Djensonsan/EE5/Arduino Ventilator/readme

All resources for the Arduino Uno that implements: Motor shield for the ventilator, temperature sensor and CAN bus communication.
