Djensonsan/EE5/Mower_1/PCB + SCH + BOM/mini-position-sensor.brd

## EAGLE design Mower_1/PCB + SCH + BOM/mini-position-sensor.brd (2019-05-21)

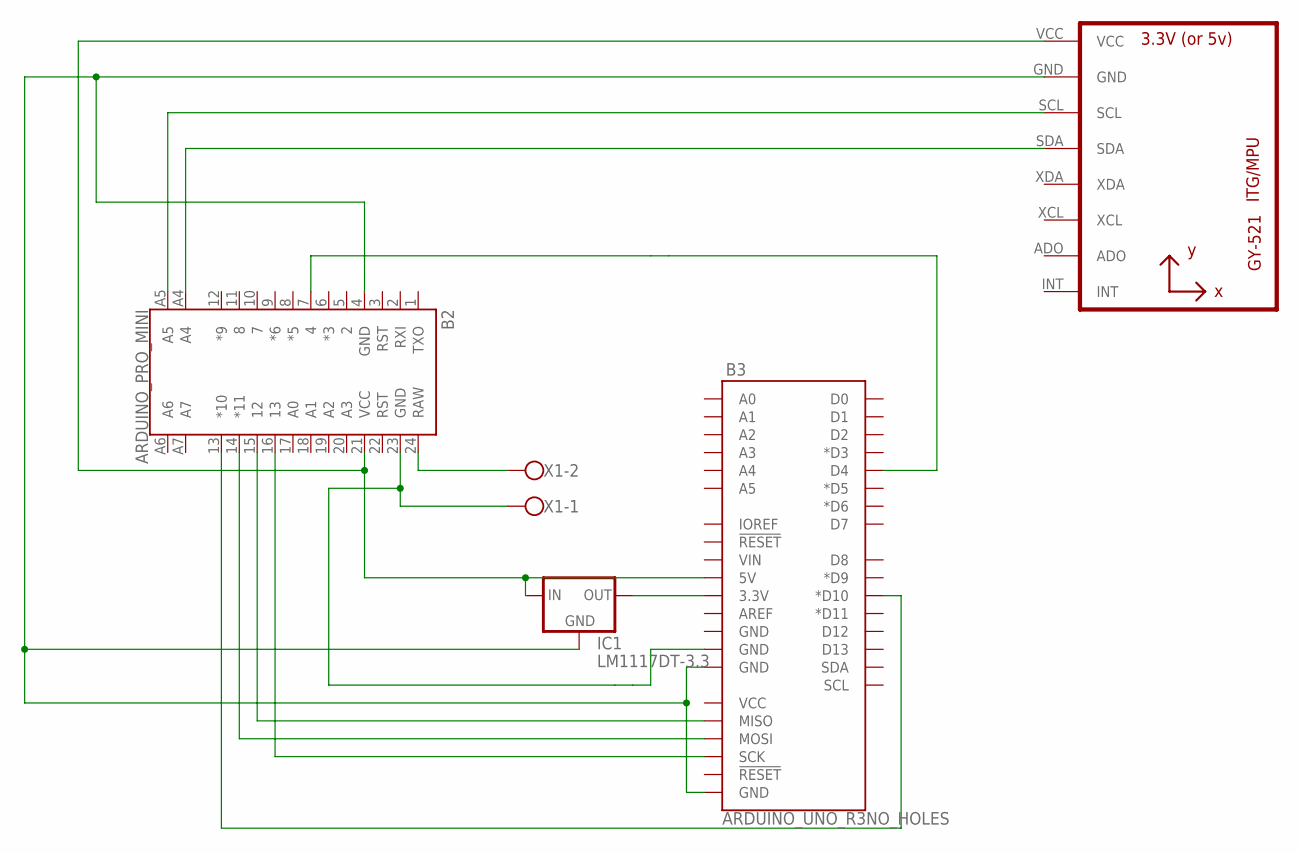
[picture p21: schematic mini-position-sensor.sch]

Parts:
B2: ARDUINO_PRO_MINI
B3: ARDUINO_UNO_R3NO_HOLES; ARDUINO_R3_NO_HOLES
IC1: LM1117DT-3.3; TO252
U1: GY-521MPU6050; GY-521
X1: W237-102

Connections:
unnamed: B2.7 (4), B3.D4
unnamed: B2.4 (GND), B3.GND@1 (GND), B3.GND@2 (GND), IC1.1 (GND), U1.GND
unnamed: B2.14 (*11), B3.MOSI
unnamed: B2.15 (12), B3.MISO
unnamed: B2.A4, U1.SDA
unnamed: B2.A5, U1.SCL
unnamed: B3.3.3V, IC1.3 (OUT)
unnamed: B2.24 (RAW), X1.2
unnamed: B2.16 (13), B3.SCK
unnamed: B2.13 (*10), B3.D10 (*D10)
unnamed: B2.23 (GND), B3.GND@3 (GND), X1.1
unnamed: B2.21 (VCC), B3.5V, IC1.2 (IN), U1.VCC

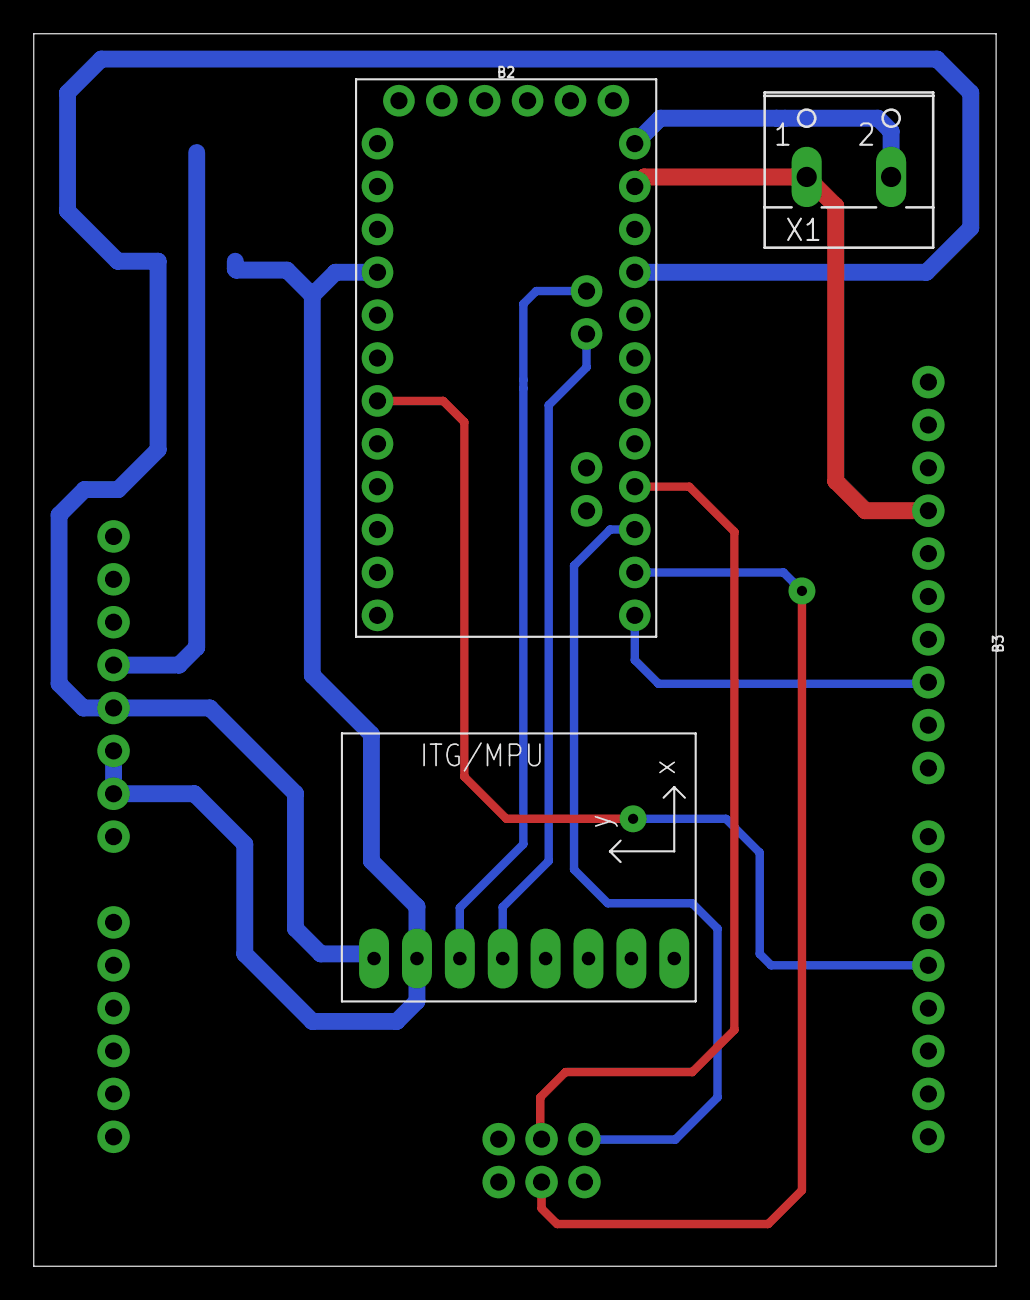
[picture p22: board mini-position-sensor.brd from above]

Board: 2 copper layers, 57.0 x 73.0 mm, 5 parts (1 on the bottom side), 12 nets.
