Djensonsan/EE5/Mower_1/PCB + SCH + BOM/amplifier.brd

## EAGLE design Mower_1/PCB + SCH + BOM/amplifier.brd (2019-05-21)

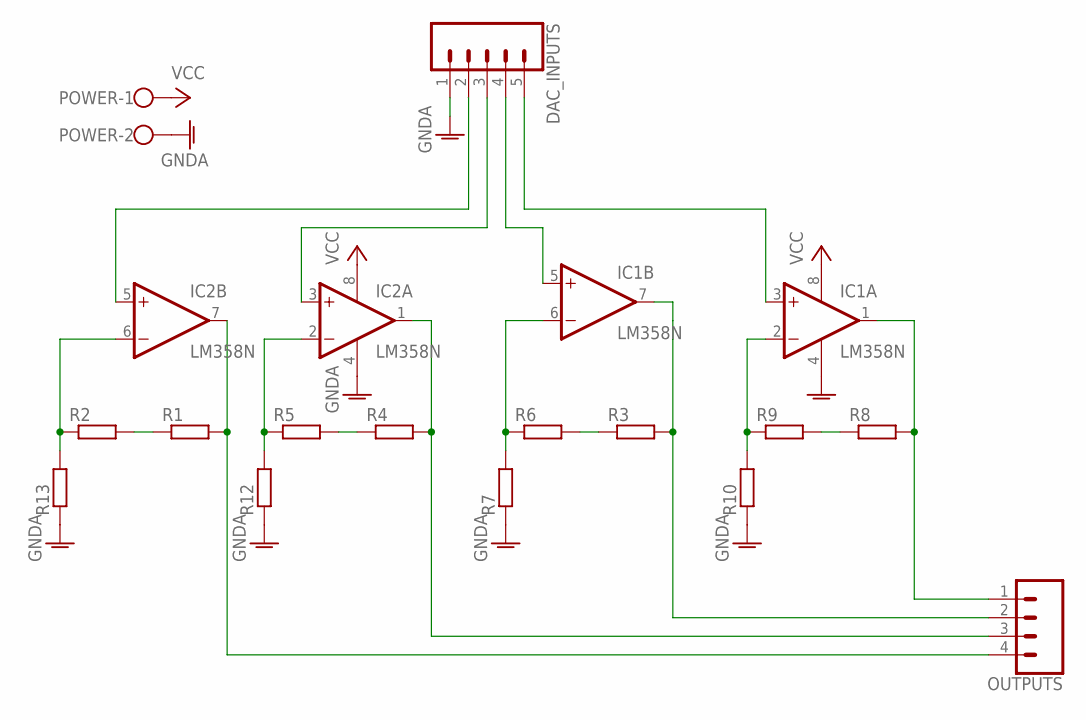
[picture p23: schematic amplifier.sch]

Parts:
DAC_INPUTS: CONN_05; 1X05
IC1, IC2: LM358N; DIL08
OUTPUTS: CONN_04; 1X04
POWER: W237-102
R1, R2, R3, R4, R5, R6, R7, R8, R9, R10, R12, R13: R-EU_0204/7; 0204/7

Connections:
GNDA: DAC_INPUTS.1, IC1.4 (V-), IC2.4 (V-), POWER.2, R7.1, R10.1, R12.1, R13.1
unnamed: DAC_INPUTS.5, IC1.3 (+IN)
unnamed: DAC_INPUTS.3, IC2.3 (+IN)
unnamed: DAC_INPUTS.4, IC1.5 (+IN)
unnamed: DAC_INPUTS.2, IC2.5 (+IN)
unnamed: IC2.1 (OUT), OUTPUTS.3, R4.2
unnamed: IC2.2 (-IN), R5.1, R12.2
unnamed: R4.1, R5.2
unnamed: IC2.7 (OUT), OUTPUTS.4, R1.2
unnamed: R1.1, R2.2
unnamed: IC2.6 (-IN), R2.1, R13.2
unnamed: R3.1, R6.2
unnamed: IC1.6 (-IN), R6.1, R7.2
unnamed: IC1.7 (OUT), OUTPUTS.2, R3.2
unnamed: R8.1, R9.2
unnamed: IC1.2 (-IN), R9.1, R10.2
unnamed: IC1.1 (OUT), OUTPUTS.1, R8.2
VCC: IC1.8 (V+), IC2.8 (V+), POWER.1

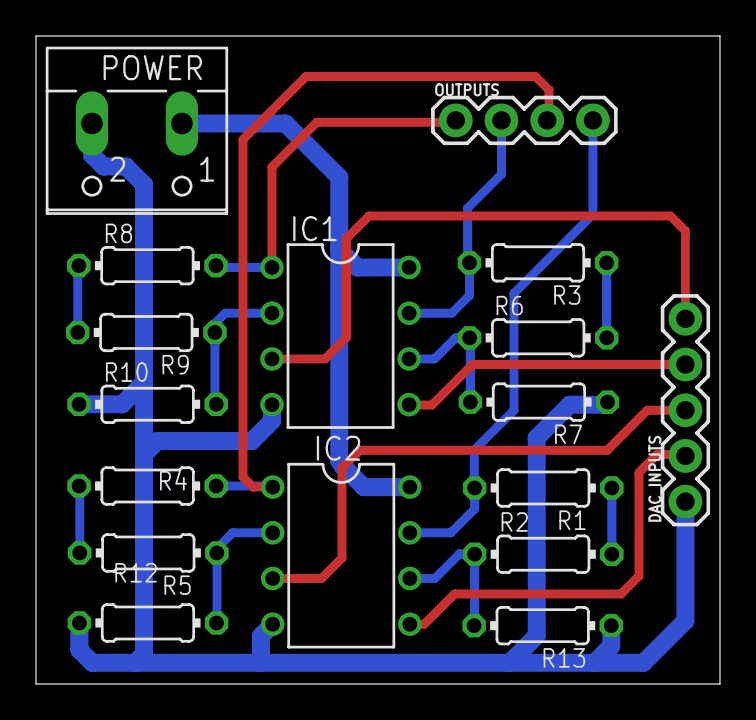
[picture p24: board amplifier.brd from above]

Board: 2 copper layers, 38.0 x 36.0 mm, 17 parts (0 on the bottom side), 18 nets.
