Djensonsan/EE5/Mower_1/PCB + SCH + BOM/mega-shield.brd

## EAGLE design Mower_1/PCB + SCH + BOM/mega-shield.brd (2019-05-21)

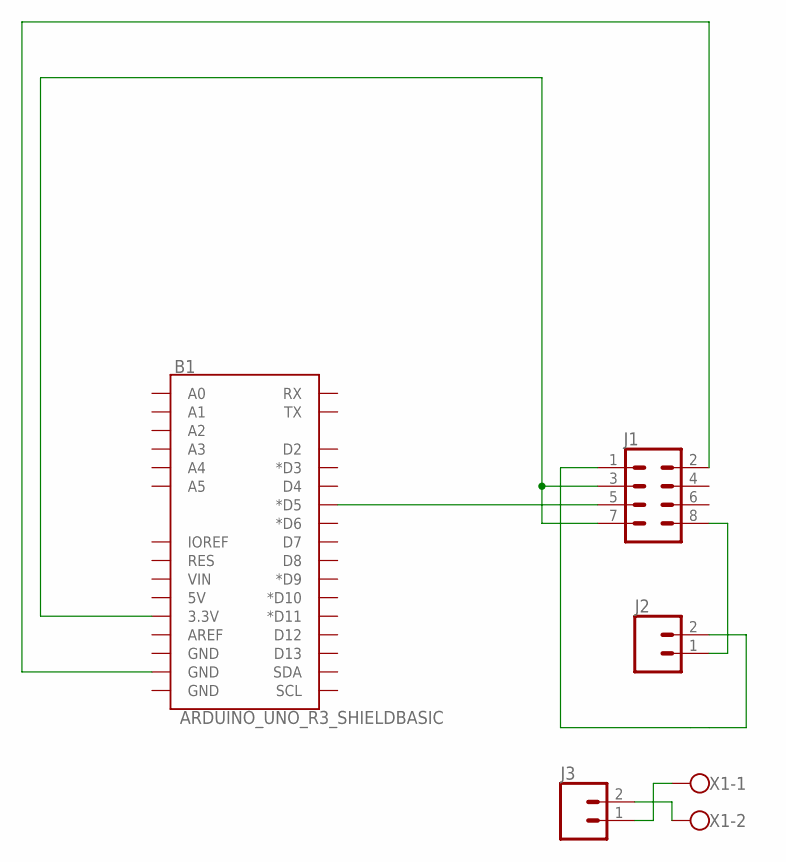
[picture p25: schematic mega-shield.sch]

Parts:
B1: ARDUINO_UNO_R3_SHIELDBASIC; UNO_R3_SHIELD
J1: CONN_04X2; 2X4
J2, J3: CONN_02; 1X02
X1: W237-102

Connections:
unnamed: B1.3.3V, J1.3, J1.7
unnamed: J1.8, J2.1
unnamed: B1.D5 (*D5), J1.5
unnamed: J1.1, J2.2
unnamed: J3.1, X1.1
unnamed: B1.GND@1 (GND), J1.2
unnamed: J3.2, X1.2

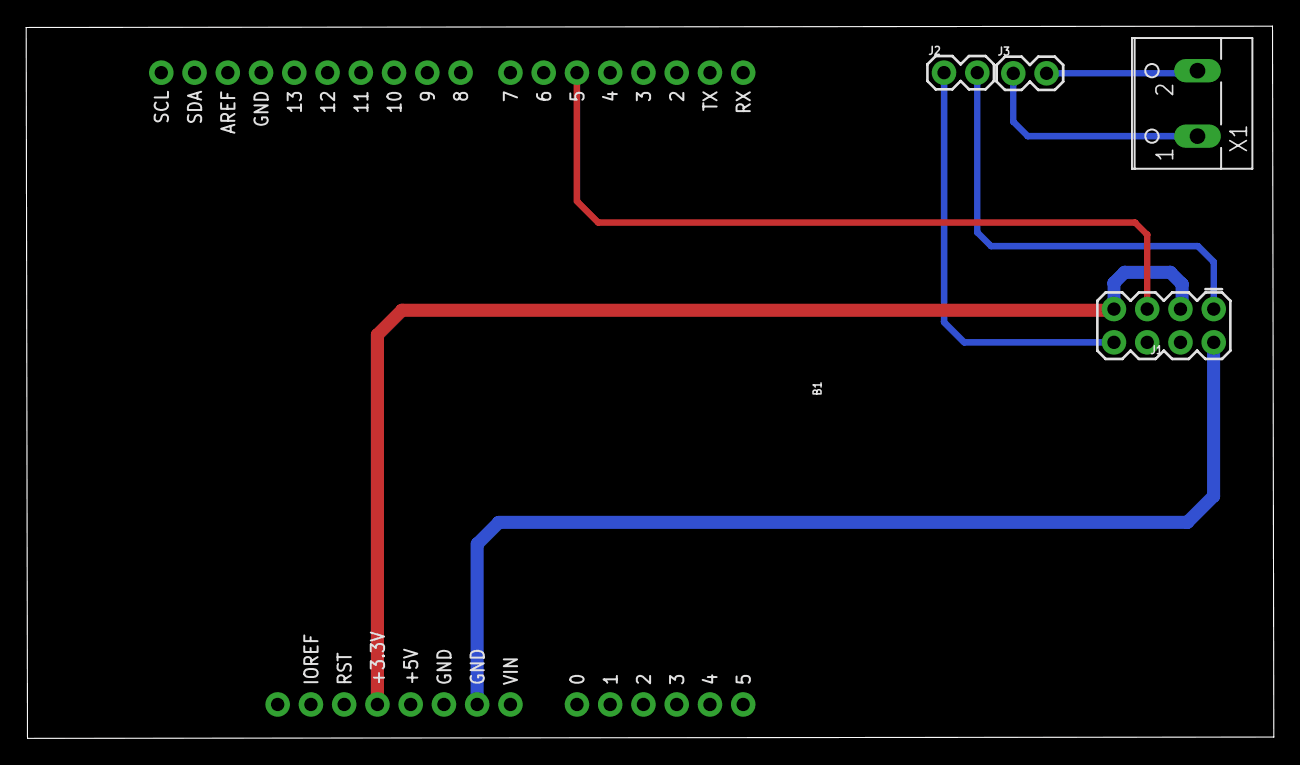
[picture p26: board mega-shield.brd from above]

Board: 2 copper layers, 95.3 x 54.4 mm, 5 parts (0 on the bottom side), 7 nets.
