Djensonsan/EE5/Mower_1/PCB + SCH + BOM/joystick-DAC-GPS.brd

## EAGLE design Mower_1/PCB + SCH + BOM/joystick-DAC-GPS.brd (2019-05-21)

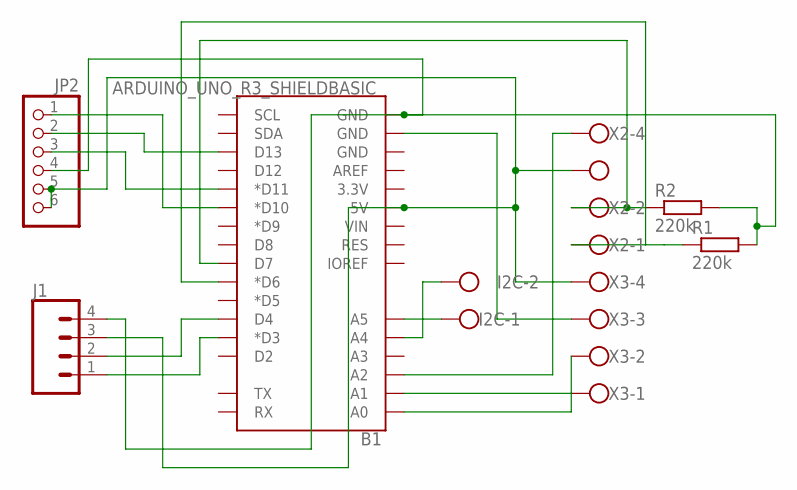
[picture p27: schematic joystick-DAC-GPS.sch]

Parts:
B1: ARDUINO_UNO_R3_SHIELDBASIC; UNO_R3_SHIELD
I2C: W237-102
J1: CONN_04; 1X04
JP2: PINHD-1X6; 1X06
R1, R2: 220k; 0204/7
X2, X3: W237-4

Connections:
unnamed: B1.5V, J1.3, JP2.5, JP2.6, X2.3, X3.4
unnamed: B1.A0, X3.2
unnamed: B1.A1, X3.1
unnamed: B1.GND@1 (GND), X3.3
unnamed: B1.GND@0 (GND), J1.4, JP2.4, R1.2, R2.2
unnamed: B1.A4, I2C.2
unnamed: B1.A5, I2C.1
unnamed: B1.A2, X2.4
unnamed: B1.D10 (*D10), JP2.1
unnamed: B1.D7, R2.1, X2.2
unnamed: B1.D11 (*D11), JP2.3
unnamed: B1.D13, JP2.2
unnamed: B1.D6 (*D6), R1.1, X2.1
unnamed: B1.D3 (*D3), J1.1
unnamed: B1.D4, J1.2

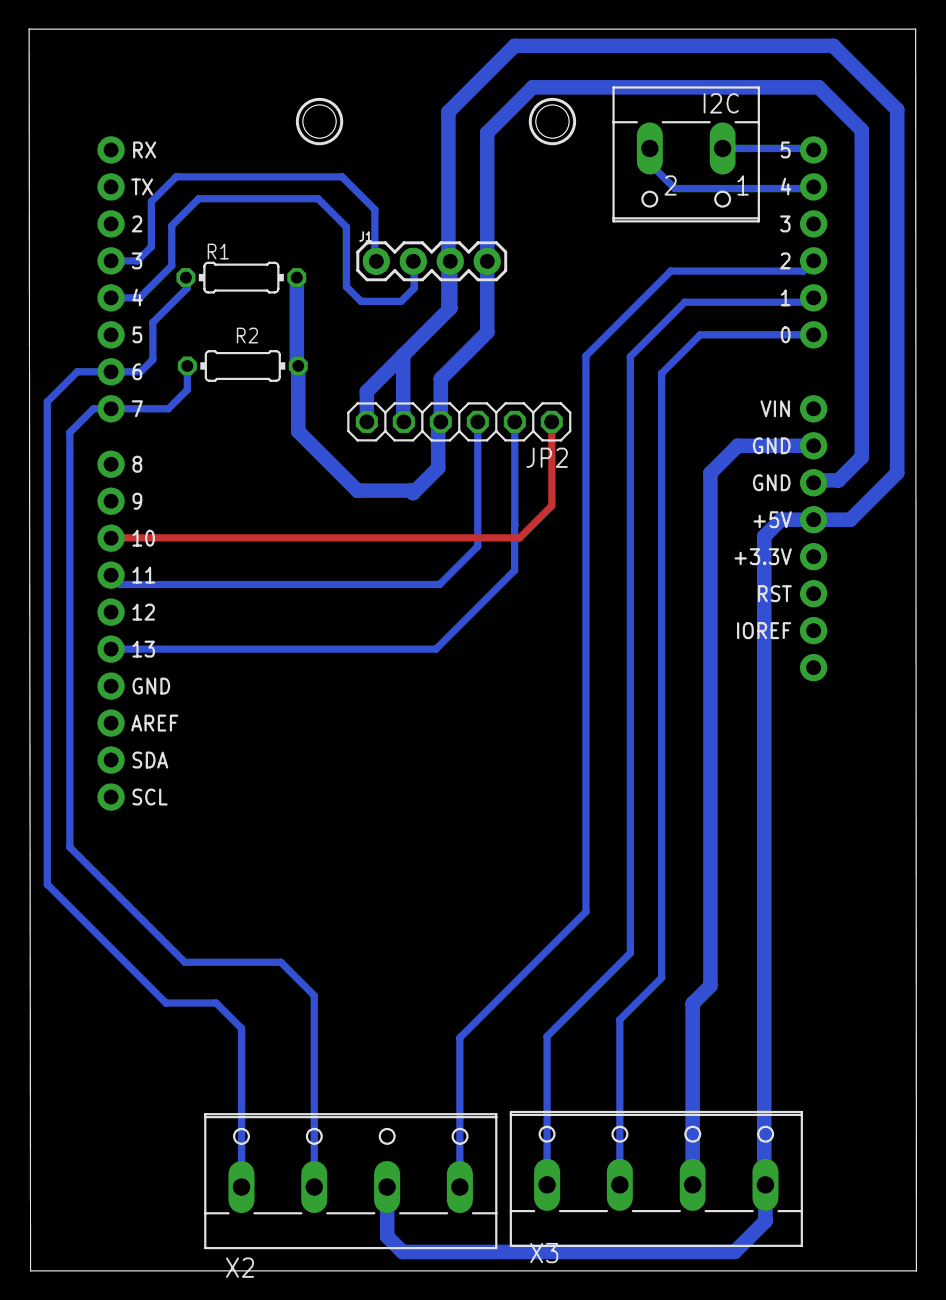
[picture p28: board joystick-DAC-GPS.brd from above]

Board: 2 copper layers, 61.0 x 85.3 mm, 8 parts (0 on the bottom side), 15 nets.
