Djensonsan/EE5/Mower_1/Arduino_Position_Sensors/Arduino_rotation.ino

//Code taken from MPU6050-DMP example code by Jeff Rowberg to which we added code to get a reference value for the gyroscope
#include "I2Cdev.h"
#include "MPU6050_6Axis_MotionApps20.h"
#include "Wire.h"
#include "df_can.h"

MPU6050 mpu;
MCPCAN CAN(10);

// MPU control/status vars
bool dmpReady = false;  // set true if DMP init was successful
uint8_t mpuIntStatus;   // holds actual interrupt status byte from MPU
uint8_t devStatus;      // return status after each device operation (0 = success, !0 = error)
uint16_t packetSize;    // expected DMP packet size (default is 42 bytes)
uint16_t fifoCount;     // count of all bytes currently in FIFO
uint8_t fifoBuffer[64]; // FIFO storage buffer

Quaternion q;           // [w, x, y, z]         quaternion container
VectorFloat gravity;    // [x, y, z]            gravity vector
float ypr[3];           // [yaw, pitch, roll]   yaw/pitch/roll container and gravity vector

float initialAngle;
float rotation;
float prevRotation, prevRead;
bool mode;
union sensor_data_t //struct to split data into bytes to be sent over CAN  bus
{
  float value;
  byte bytes[4];
};

volatile bool mpuInterrupt = false;     // indicates whether MPU interrupt pin has gone high
void dmpDataReady()
{
  mpuInterrupt = true;
}


void setup() {



  Wire.begin();
  TWBR = 24; // 400kHz I2C clock (200kHz if CPU is 8MHz)

  Serial.begin(115200);
  while (!Serial);

  Serial.println(F("Initializing I2C devices..."));
  mpu.initialize();

  Serial.println(F("Testing device connections..."));
  Serial.println(mpu.testConnection() ? F("MPU6050 connection successful") : F("MPU6050 connection failed"));

  Serial.println(F("Initializing DMP..."));
  devStatus = mpu.dmpInitialize();

  mpu.setXGyroOffset(220);
  mpu.setYGyroOffset(76);
  mpu.setZGyroOffset(-85);
  mpu.setZAccelOffset(1788); 

  if (devStatus == 0)
  {
    // turn on the DMP, now that it's ready
    Serial.println(F("Enabling DMP..."));
    mpu.setDMPEnabled(true);

    // enable Arduino interrupt detection
    Serial.println(F("Enabling interrupt detection (Arduino external interrupt 0)..."));
    attachInterrupt(0, dmpDataReady, RISING);
    mpuIntStatus = mpu.getIntStatus();

    // set DMP Ready flag so the main loop() function knows it's okay to use it
    Serial.println(F("DMP ready! Waiting for first interrupt..."));
    dmpReady = true;

    // get expected DMP packet size for later comparison
    packetSize = mpu.dmpGetFIFOPacketSize();
  }
  else
  {
    // ERROR!
    // 1 = initial memory load failed
    // 2 = DMP configuration updates failed
    // (if it's going to break, usually the code will be 1)
    Serial.print(F("DMP Initialization failed (code "));
    Serial.print(devStatus);
    Serial.println(F(")"));
  }

  prevRotation = 0;
  prevRead = 0;
  mode = 0;
 
   initializeAngle(); //function to the initial reading of the gyroscope and set that as a refrence
    
   int count = 50;                                     // the max numbers of initializint the CAN-BUS, if initialize failed first!.
  Serial.print("Initializing can controlor...");
  do {
    CAN.init();   //must initialize the Can interface here!
    if (CAN_OK == CAN.begin(CAN_500KBPS))                  // init can bus : baudrate = 500k
    {
      Serial.println("DFROBOT's CAN BUS Shield init ok!");
      break;
    }
    else
    {
      Serial.println("DFROBOT's CAN BUS Shield init fail");
      Serial.println("Please Init CAN BUS Shield again");

      delay(100);
      if (count <= 1)
        Serial.println("Please give up trying!, trying is useless!");
    }

  } while (count--);

  

}

void loop() {
  // if programming failed, don't try to do anything
  if (!dmpReady) return;

  // wait for MPU interrupt or extra packet(s) available
  while (!mpuInterrupt && fifoCount < packetSize)  {}

  // reset interrupt flag and get INT_STATUS byte
  mpuInterrupt = false;
  mpuIntStatus = mpu.getIntStatus();

  // get current FIFO count
  fifoCount = mpu.getFIFOCount();

  // check for overflow (this should never happen unless our code is too inefficient)
  if ((mpuIntStatus & 0x10) || fifoCount == 1024) {
    // reset so we can continue cleanly
    mpu.resetFIFO();
    Serial.println(F("FIFO overflow!"));

    // otherwise, check for DMP data ready interrupt (this should happen frequently)
  }
  else if (mpuIntStatus & 0x02)
  {
    // wait for correct available data length, should be a VERY short wait
    while (fifoCount < packetSize) fifoCount = mpu.getFIFOCount();
    mpu.getFIFOBytes(fifoBuffer, packetSize);
    fifoCount -= packetSize;

    mpu.dmpGetQuaternion(&q, fifoBuffer);
    mpu.dmpGetGravity(&gravity, &q);
    mpu.dmpGetYawPitchRoll(ypr, &q, &gravity);

    rotation = ypr[0] * 180 / M_PI + 180;

    //Calculate angle value with the inital reading as a zero refrence
    if (rotation - prevRead > 350)
    {
      mode = 0;
    }

    if (rotation - prevRead < -350)
    {
      mode = 1;
    }
    prevRead = rotation;
    switch (mode)
    {
      case 0:
        rotation = rotation - initialAngle;
        break;
      case 1:
        rotation = rotation + 360 - initialAngle;
        break;
    }
    
    // If angle changed by 5 dgrees or more, value is sent over CAN bus
    if (abs(rotation - prevRotation) > 5)
    {
      Serial.println("printing rotation");
      Serial.println(rotation);
      prevRotation = rotation;
      sensor_data_t sensor_data;
      sensor_data.value = rotation;
      byte data[4] = {sensor_data.bytes[0], sensor_data.bytes[1], sensor_data.bytes[2], sensor_data.bytes[3]};
      CAN.sendMsgBuf(0x07, 0, 4, data);
    }
  }

}

void initializeAngle()
{
  Serial.println("Initializing angle");
  int count = 0;
  
  //loop to give time for gyroscope initial value to settle 
  while (count < 2000)
  {
    count++;
    if (!dmpReady) return;
    while (!mpuInterrupt && fifoCount < packetSize) {}

    mpuInterrupt = false;
    mpuIntStatus = mpu.getIntStatus();
    fifoCount = mpu.getFIFOCount();
    if ((mpuIntStatus & 0x10) || fifoCount == 1024)
    {
      mpu.resetFIFO();
      Serial.println(F("FIFO overflow!"));
    }
    else if (mpuIntStatus & 0x02)
    {
      while (fifoCount < packetSize) fifoCount = mpu.getFIFOCount();
      mpu.getFIFOBytes(fifoBuffer, packetSize);
      fifoCount -= packetSize;
      mpu.dmpGetQuaternion(&q, fifoBuffer);
      mpu.dmpGetGravity(&gravity, &q);
      mpu.dmpGetYawPitchRoll(ypr, &q, &gravity);
    }
  }
  initialAngle = (ypr[0] * 180 / M_PI) + 180;
  Serial.println("Initial Angle");
  Serial.println(initialAngle);
}
