Djensonsan/EE5/(commit log)

2019-04-03 Create Arduino Joystick
2019-04-03 Rename CAN Bus receiver to Test_CANBusReceiver
2019-04-03 Rename Arduino Joystick to Arduino_Joystick
2019-04-04 Update Arduino_Master
2019-04-15 Create positionSensor_kalmanFilter
    Implemented both Kalman filter and complementary filter and compare both results.
    The library of the Kalman filter can be downloaded in the following page:
    https://github.com/TKJElectronics/KalmanFilter
2019-04-26 Create Arduino_Position_Sensor_V2
    The latest version up to 4/26/2019
    New features:
    1) User-defined filter by setting MODE to be 0(Kalman) or 1(Complementary)
    2) Implemented a circular buffer and averaging the raw value from MPU to get rid of the vibration effect
2019-04-26 The latest version of Position sensor up to 4/26
    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
    [Arduino_Position_SensorV2.ino]
2019-05-06 Update Arduino_Joystick
2019-05-20 Update and rename Arduino_Joystick to Arduino_Joystick.ino
2019-05-22 Update and rename Arduino_Position_Sensor.ino to Arduino_Position_Sensor_X.ino
